R-Mutura/HDMI-T0-MIPI-2/hdmi_to_mipi-dsi_converter/assets/PCB Design.jpg

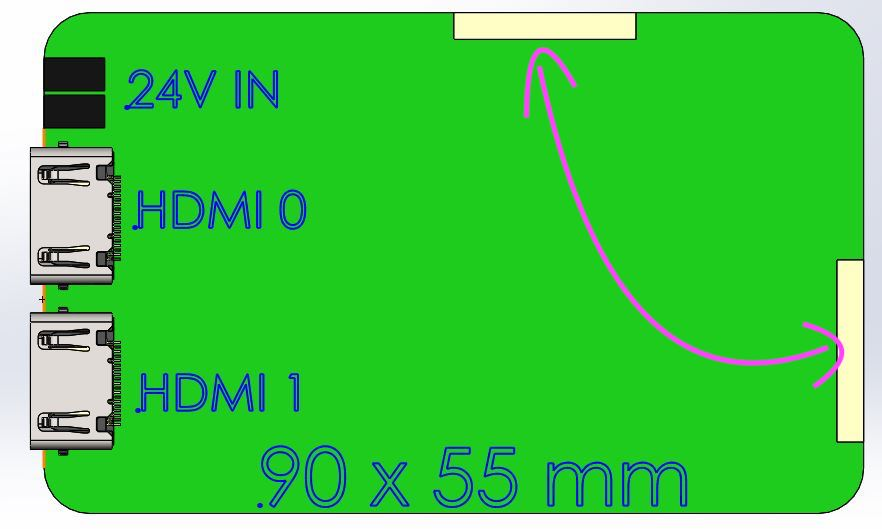
hdmi_to_mipi-dsi_converter/assets/PCB Design.jpg
