R-Mutura/HDMI-T0-MIPI-2/hdmi_to_mipi-dsi_converter/assets/image (2).png

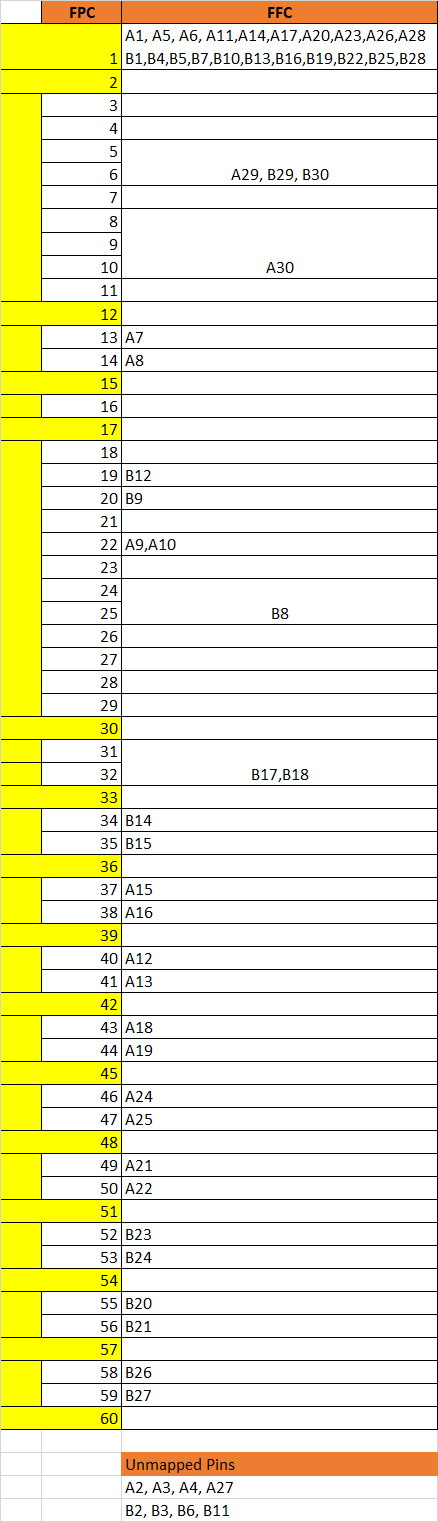
hdmi_to_mipi-dsi_converter/assets/image (2).png
