R-Mutura/HDMI-T0-MIPI-2/hdmi_to_mipi-dsi_converter/assets/TC358870_1.jpeg

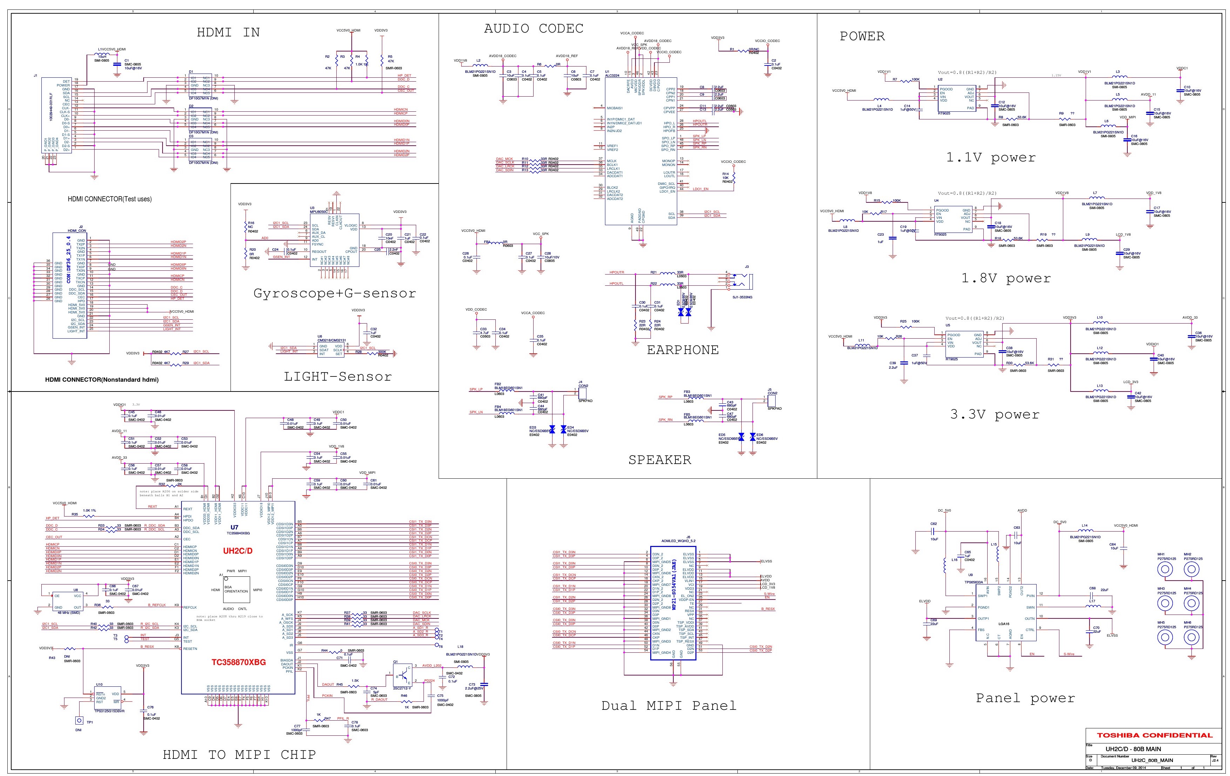
hdmi_to_mipi-dsi_converter/assets/TC358870_1.jpeg
