R-Mutura/HDMI-T0-MIPI-2/hdmi_to_mipi-dsi_converter/img/hdmi_to_mipi-dsi_converter_3.png

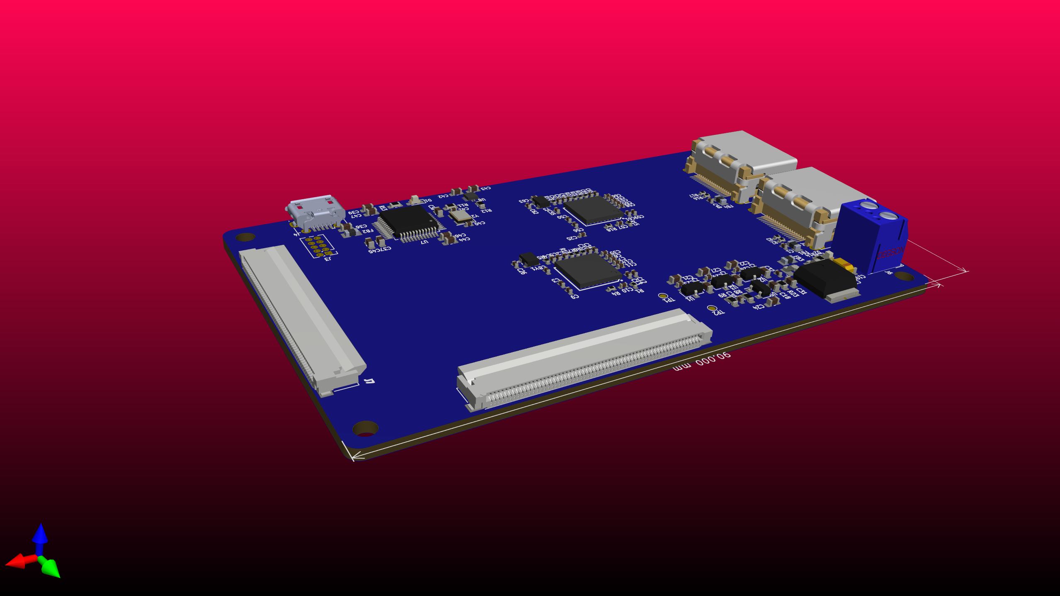
hdmi_to_mipi-dsi_converter/img/hdmi_to_mipi-dsi_converter_3.png
