R-Mutura/HDMI-T0-MIPI-2/hdmi_to_mipi-dsi_converter/bom/hdmi_to_mipi-dsi_converterV2.xlsx

Reference | Quantity | Value | Footprint | Mfr | Mfr# | Supplier
C13 C14 C11 C7 C3 C5 C9 C1 C32 C60 C61 C58 C54 C50 C52 C56 C48 | 17 | 10n | Capacitor_SMD:C_0402_1005Metric | YAGEO | CC0402KRX5R8BB103 | LCSC
C20 | 1 | 10u | Capacitor_Tantalum_SMD:CP_EIA-3216-18_Kemet-A | KEMET | T491A106K016AT | LCSC
C25 C12 C10 C6 C2 C4 C8 C35 C34 C33 C37 C38 C39 C42 C43 C28 C30 C29 C23 C59 C57 C49 C51 C55 C66 C65 C64 C53 C62 | 29 | 0.1u | Capacitor_SMD:C_0402_1005Metric | YAGEO | CC0402KRX7R7BB104 | LCSC
C26 C63 | 2 | 0.01u | Capacitor_SMD:C_0402_1005Metric | YAGEO | CC0402KRX5R8BB103 | LCSC
C19 C31 | 2 | 0.1u | Capacitor_SMD:C_0603_1608Metric | YAGEO | CC0603ZRY5V9BB104 | LCSC
C40 C41 | 2 | 18p | Capacitor_SMD:C_0402_1005Metric | YAGEO | CC0402JRNPO9BN180 | LCSC
C36 C15 C16 C17 C18 C24 C27 C21 C22 | 9 | 10u | Capacitor_SMD:C_0603_1608Metric | YAGEO | CC0603KRX5R6BB106 | LCSC
C44 C45 | 2 | 10u | Capacitor_SMD:C_0402_1005Metric | YAGEO | CC0402MRX5R5BB106 | LCSC
C46 C47 | 2 | 4.7u | Capacitor_SMD:C_0603_1608Metric | YAGEO | CC0603KRX5R6BB475 | LCSC
D1 D2 | 2 | LED_Small | LED_SMD:LED_0603_1608Metric_Castellated | Lite-On | LTST-C191KGKT | LCSC
FB1 FB4 | 2 | Ferrite_Bead_Small | Barrel - Audio Connectors:BEADC2012X105N | Murata Electronics | BLM21PG220SN1D | LCSC
FB2 FB3 | 2 | BLM21PG220SN1 | Barrel - Audio Connectors:BEADC2012X105N | Murata Electronics | BLM21PG220SN1D | LCSC
J2 J1 | 2 | HDMI-019S | HDMI:HDMI-019S | SOFNG | HDMI-019S | LCSC
J3 | 1 | Conn_02x05_Odd_Even | Connector_PinHeader_1.27mm:PinHeader_2x05_P1.27mm_Vertical | Amphenol ICC (FCI) | 20021111-00010T1LF | DIGIKEY
J4 | 1 | USB_B_Micro | Connector_USB:USB_Micro-B_Molex-105017-0001 | MOLEX | 1050170001 | LCSC
J5 J7 | 2 | XF2M60151AH | 60_PIN_FPC:XF2M60151AH | Omron Electronics | XF2M-6015-1AH | LCSC
J6 | 1 | Conn_01x02 | TerminalBlock_4Ucon:TerminalBlock_4Ucon_1x02_P3.50mm_Horizontal | Cixi Kefa Elec | KF350-3.5-2P | LCSC
R1 R10 R22 R15 | 4 | 2k | Resistor_SMD:R_0402_1005Metric | YAGEO | RC0402JR-072KL | LCSC
R12 | 1 | 47k | Resistor_SMD:R_0603_1608Metric | YAGEO | RC0603FR-0747KL | LCSC
R13 R14 | 2 | 1k | Resistor_SMD:R_0603_1608Metric | YAGEO | AC0603FR-071KL | LCSC
R2 R3 R4 R16 R18 R17 | 6 | 47k | Resistor_SMD:R_0402_1005Metric | YAGEO | RC0402DR-0747KL | LCSC
R23 | 1 | 0R | Resistor_SMD:R_0603_1608Metric | YAGEO | RC0603JR-070RL | LCSC
R5 R19 | 2 | 33R | Resistor_SMD:R_0402_1005Metric | YAGEO | RC0402FR-0733RL | LCSC
R7 R6 R11 R21 R20 | 5 | 10k | Resistor_SMD:R_0402_1005Metric | YAGEO | SR0402FR-0710KL | LCSC
R8 | 1 | 4.02k | Resistor_SMD:R_0603_1608Metric | YAGEO | AC0603FR-074K02L | LCSC
R9 | 1 | 2k | Resistor_SMD:R_0603_1608Metric | YAGEO | RC0603FR-072KL | LCSC
U1 | 1 | MCP1700-1202E_SOT23 | Package_TO_SOT_SMD:SOT-23 | Microchip Tech | MCP1700-1202E_SOT23 | LCSC
U2 | 1 | MCP1700-1802E_SOT23 | Package_TO_SOT_SMD:SOT-23 | Microchip Tech | MCP1700-1802E_SOT23 | LCSC
U3 U5 | 2 | MCP1700-3302E_SOT23 | Package_TO_SOT_SMD:SOT-23 | Microchip Tech | MCP1700T-3302E/TT | LCSC
U4 U9 | 2 | TC358870XBG_NOK_ | Barrel - Audio Connectors:BGA80C65P10X10_700X700X100 | Toshiba | TC358870XBG(NOK) | MOUSER
U6 | 1 | MC78M05_TO252 | Package_TO_SOT_SMD:TO-252-2 | ON Semiconductor | MC78M05ACDTG | LCSC
U7 | 1 | STM32F103C8Tx | Package_QFP:LQFP-48_7x7mm_P0.5mm | STMicroelectronics | STM32F103C8T6 | LCSC
U8 | 1 | FXMA2104UMX | Barrel - Audio Connectors:QFN40P180X180X55-12N | ON Semiconductor | FXMA2104UMX | LCSC
Y1 Y3 | 2 | CRYSTAL_48MHZ | Barrel - Audio Connectors:DSC6101JI2A-048.0000 | Microchip Technology | DSC6101JI2A-048.0000 | DIGIKEY
Y2 | 1 | 8MHz | Crystal:Crystal_SMD_3225-4Pin_3.2x2.5mm | XTY | 7325-0800A2010-00 | LCSC
