R-Mutura/HDMI-T0-MIPI-2/hdmi_to_mipi-dsi_converter/sch_pdf/hdmi_to_mipi-dsi_converter.pdf

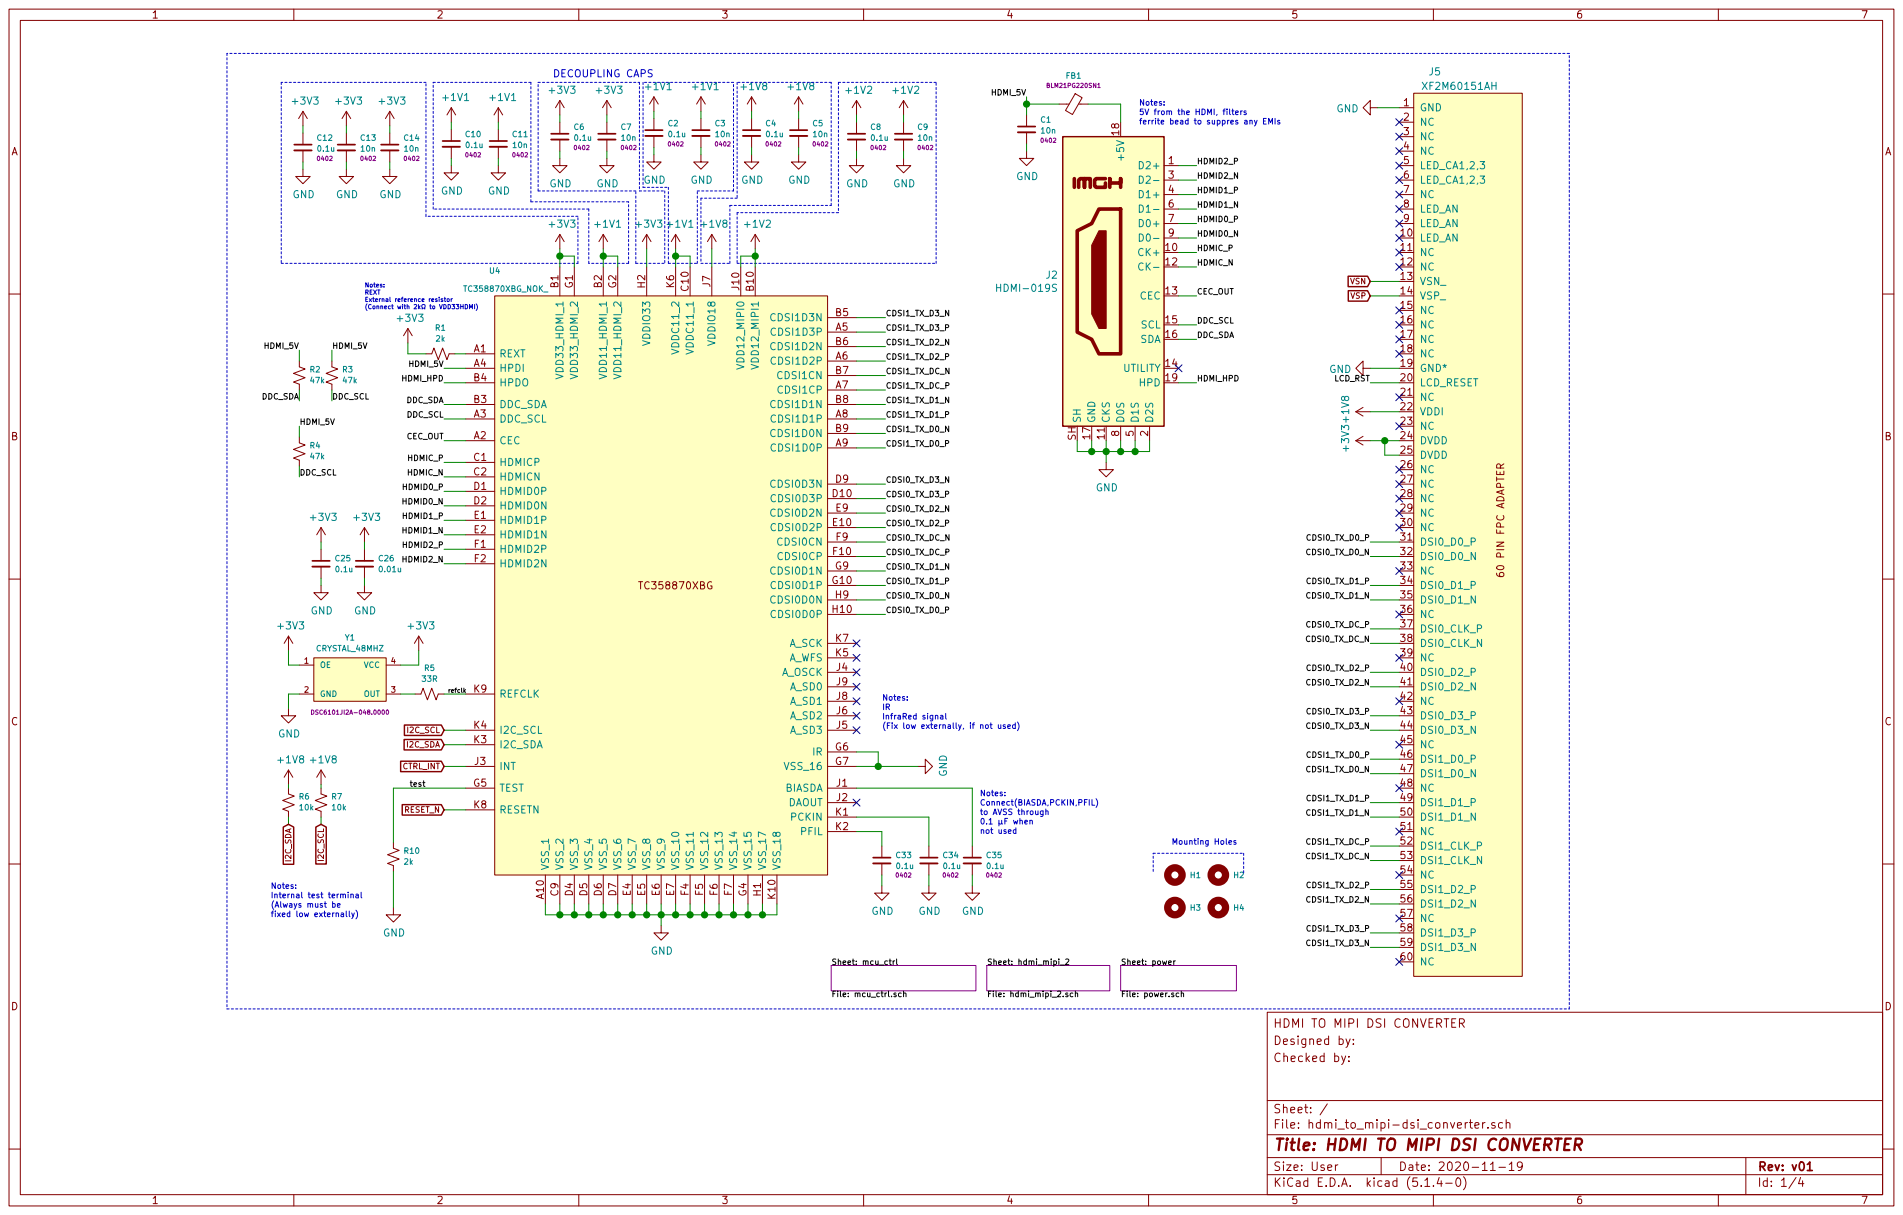
[picture p15: page 1]

Notes: 5V from the HDMI, filters

ferrite bead to suppres any EMIs

Notes: REXT External reference resistor

InfraRed signal (Fix low externally, if not used) Notes: Connect(BIASDA,PCKIN,PFIL)

Internal test terminal (Always must be

Designed by: HDMI TO MIPI DSI CONVERTER

File: hdmi_to_mipi-dsi_converter.sch Sheet: / Checked by:

Id: 1/4 Title: HDMI TO MIPI DSI CONVERTER

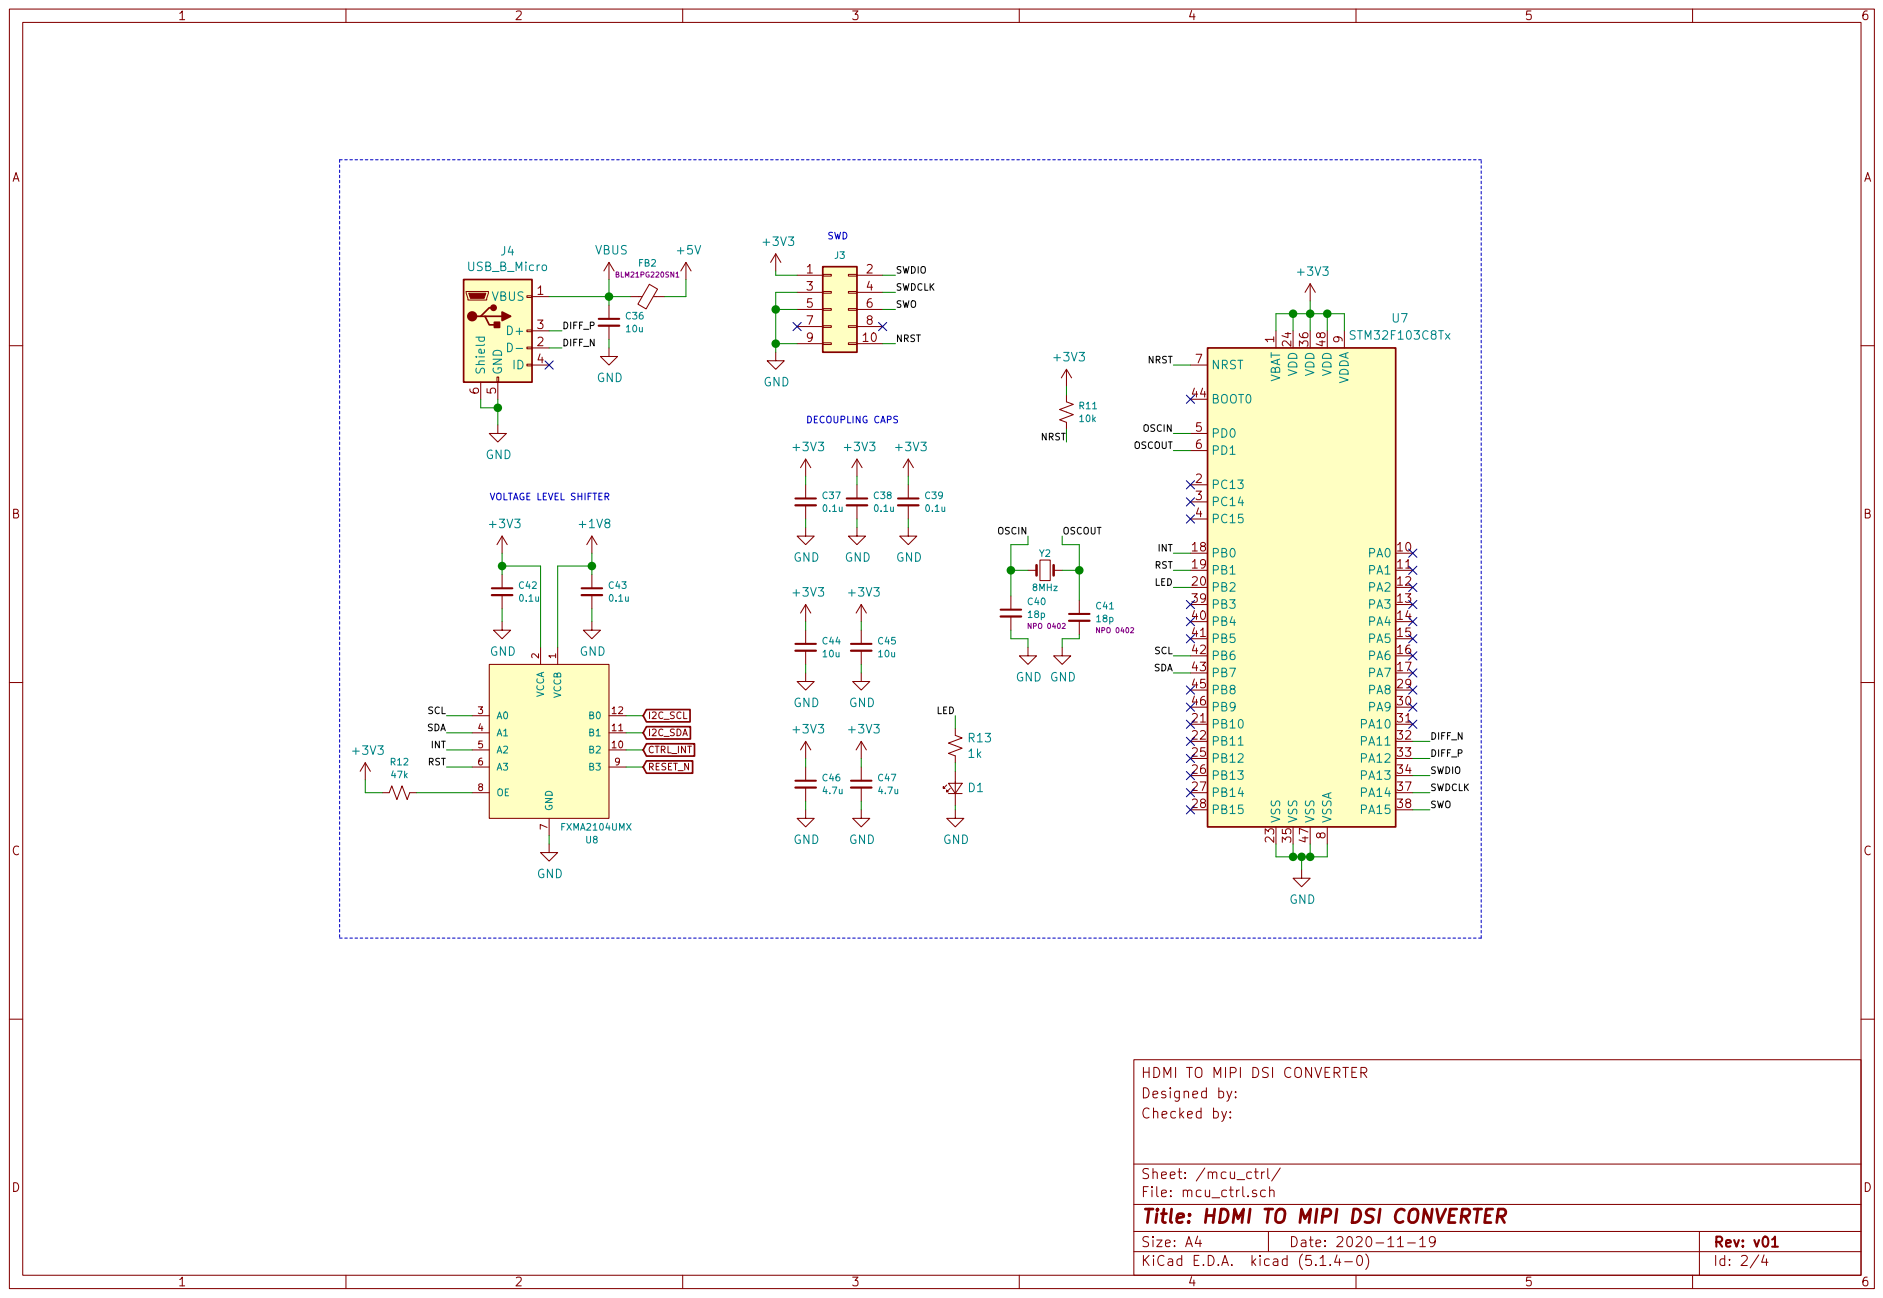
[picture p16: page 2]

1 VDD 24 VDD 36 VDD 48 VDDA

9 VSS 23 VSS 35 VSS 47 VSSA

Designed by: HDMI TO MIPI DSI CONVERTER

Sheet: /mcu_ctrl/
File: mcu_ctrl.sch
Id: 2/4 Title: HDMI TO MIPI DSI CONVERTER

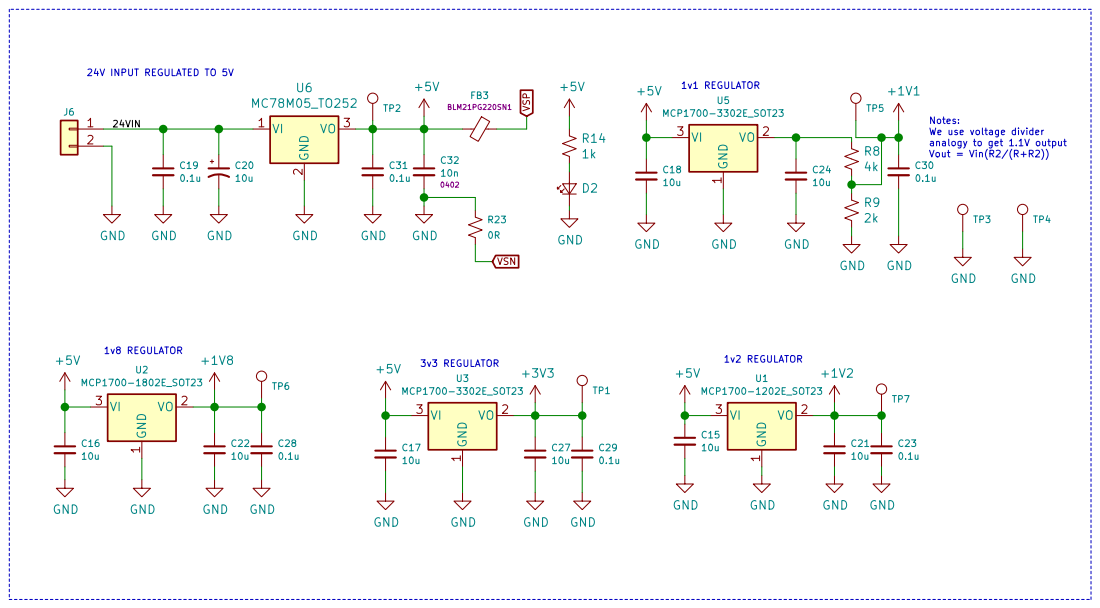
[picture p17: page 3]

1v1 REGULATOR
+1V1 GND
Designed by: HDMI TO MIPI DSI CONVERTER GND

1 VO 2 VI 3 U5 MCP1700-3302E_SOT23 GND GND GND GND

Sheet: /power/
File: power.sch
Id: 3/4 Title: HDMI TO MIPI DSI CONVERTER

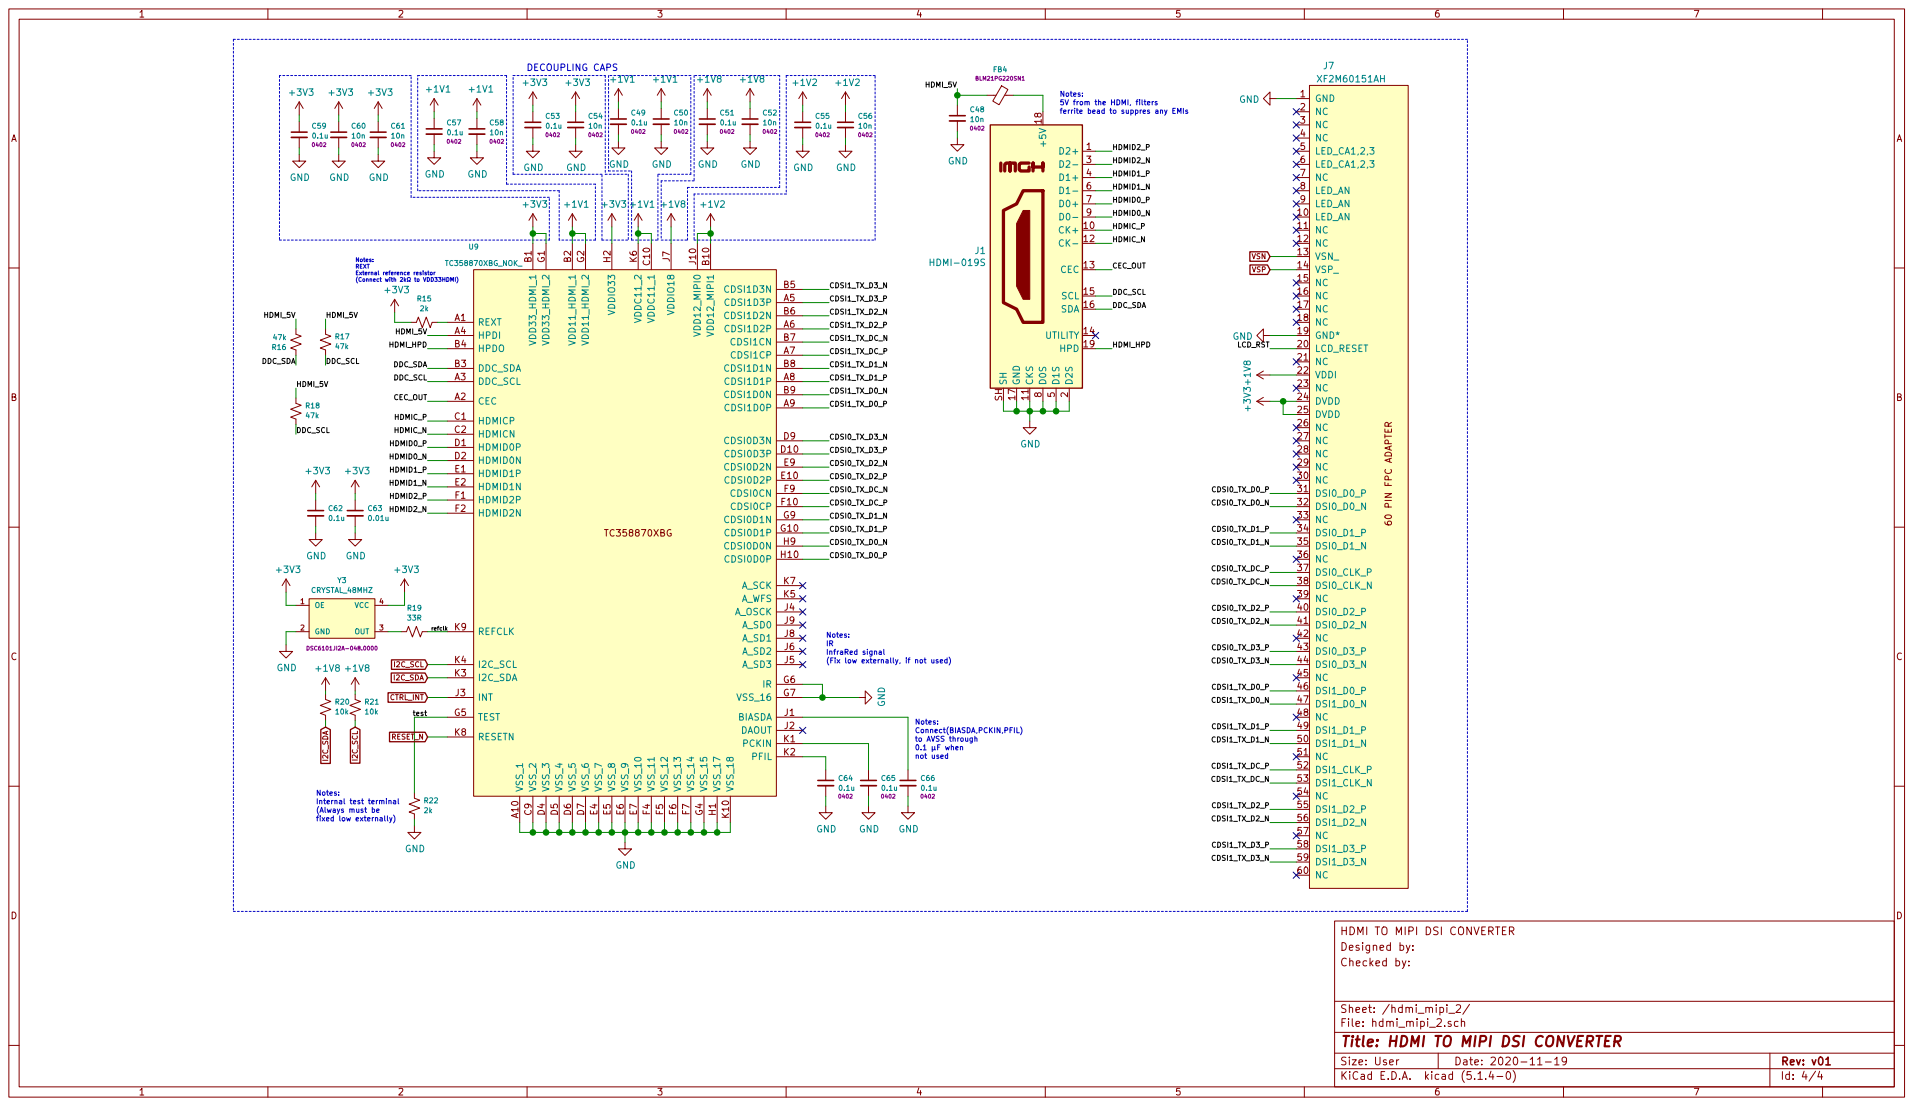
[picture p18: page 4]

ferrite bead to suppres any EMIs Notes: REXT External reference resistor

InfraRed signal (Fix low externally, if not used)

CDSI1_TX_D2_P Notes:
Internal test terminal (Always must be

Designed by: HDMI TO MIPI DSI CONVERTER

Sheet: /hdmi_mipi_2/
File: hdmi_mipi_2.sch
Id: 4/4 Title: HDMI TO MIPI DSI CONVERTER
