R-Mutura/HDMI-T0-MIPI-2/hdmi_to_mipi-dsi_converter/src_files/hdmi_to_mipi-dsi_converter.kicad_pcb

## KiCad design hdmi_to_mipi-dsi_converter/src_files/hdmi_to_mipi-dsi_converter.kicad_pcb (2021-11-17)

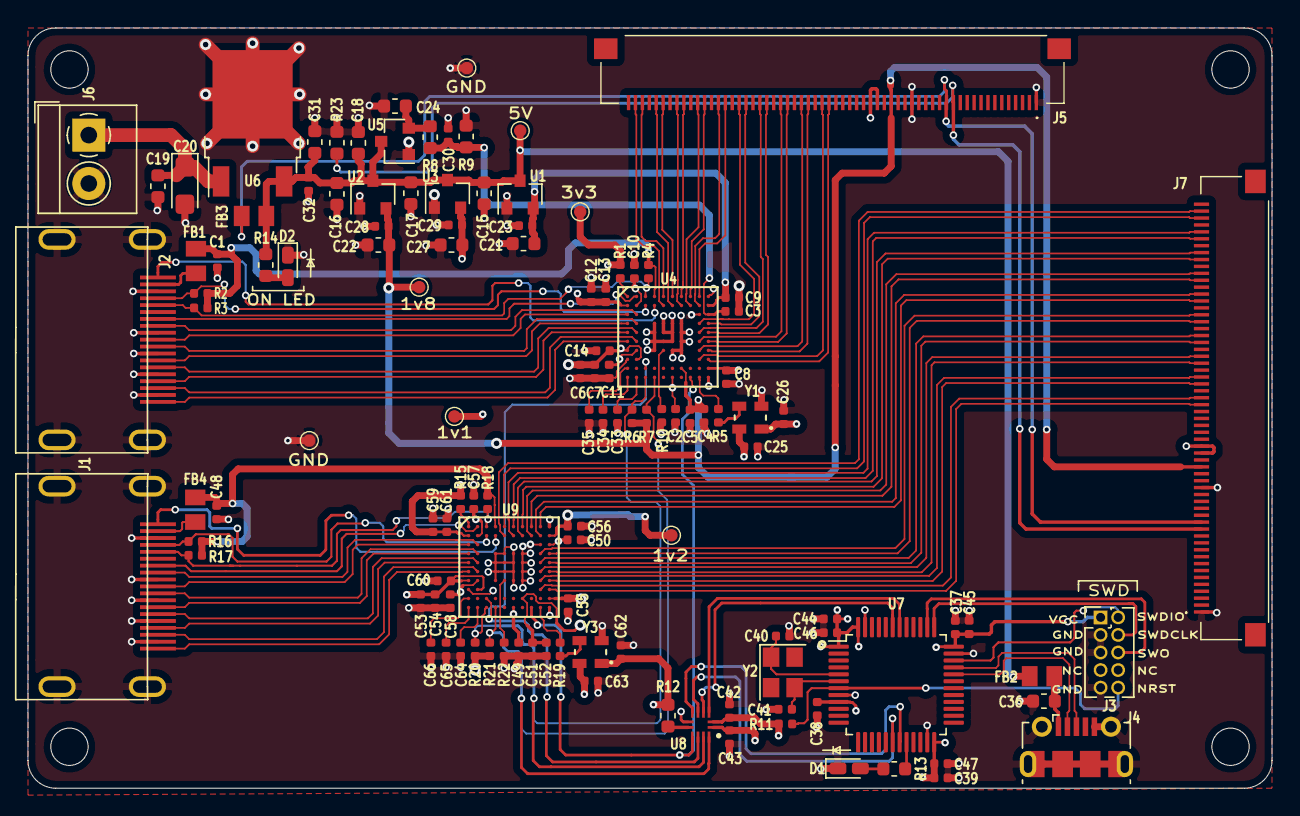
[picture p19: board hdmi_to_mipi-dsi_converter.kicad_pcb from above]

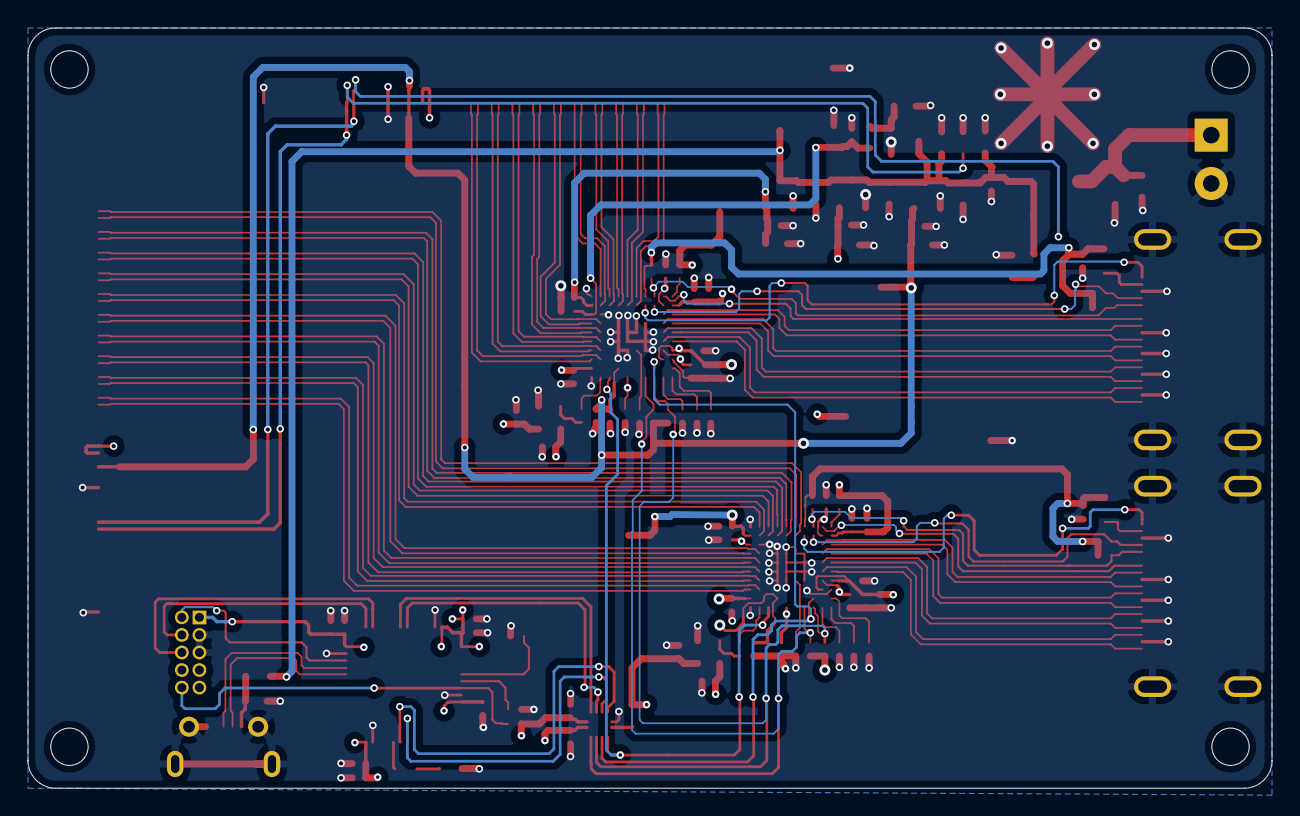
[picture p20: board hdmi_to_mipi-dsi_converter.kicad_pcb from below]

Board: 4 copper layers, 90.0 x 55.0 mm, 125 parts (4 on the bottom side), 113 nets.

Parts:
C1, C3, C5, C7, C9, C11, C13, C14, C32, C48, C50, C52, C54, C56, C58, C60, C61: 10n; C_0402_1005Metric
C2, C4, C6, C8, C10, C12, C23, C25, C28, C29, C30, C33, C34, C35, C37, C38, C39, C42, C43, C49, C51, C53, C55, C57, C59, C62, C64, C65, C66: 0.1u; C_0402_1005Metric
C15, C16, C17, C18, C21, C22, C24, C27, C36: 10u; C_0603_1608Metric
C19, C31: 0.1u; C_0603_1608Metric
C20: 10u; CP_EIA-3216-18_Kemet-A
C26, C63: 0.01u; C_0402_1005Metric
C40, C41: 18p; C_0402_1005Metric
C44, C45: 10u; C_0402_1005Metric
C46, C47: 4.7u; C_0402_1005Metric
D1, D2: LED_Small; LED_0603_1608Metric_Castellated
FB1, FB4: Ferrite_Bead_Small; BEADC2012X105N
FB2, FB3: BLM21PG220SN1; BEADC2012X105N
H1, H2, H3, H4: MountingHole; MountingHole_2.7mm_M2.5
J1, J2: HDMI-019S
J3: Conn_02x05_Odd_Even; PinHeader_2x05_P1.27mm_Vertical
J4: USB_B_Micro; USB_Micro-B_Molex-105017-0001
J5, J7: XF2M60151AH
J6: Conn_01x02; TerminalBlock_4Ucon_1x02_P3.50mm_Horizontal
R1, R10, R15, R22: 2k; R_0402_1005Metric
R2, R3, R4, R16, R17, R18: 47k; R_0402_1005Metric
R5, R19: 33R; R_0402_1005Metric
R6, R7, R11, R20, R21: 10k; R_0402_1005Metric
R8: 4k; R_0603_1608Metric
R9: 2k; R_0603_1608Metric
R12: 47k; R_0603_1608Metric
R13, R14: 1k; R_0603_1608Metric
R23: 0R; R_0603_1608Metric
TP1, TP2, TP3, TP4, TP5, TP6, TP7: TestPoint; TestPoint_Pad_D0.9mm
U1: MCP1700-1202E_SOT23; SOT-23
U2: MCP1700-1802E_SOT23; SOT-23
U3, U5: MCP1700-3302E_SOT23; SOT-23
U4, U9: TC358870XBG_NOK_; VFBGA-80_7x7mm_Pitch0.65mm
U6: MC78M05_TO252; TO-252-2
U7: STM32F103C8Tx; LQFP-48_7x7mm_P0.5mm
U8: FXMA2104UMX; QFN40P180X180X55-12N
Y1, Y3: CRYSTAL_48MHZ; DSC6101JI2A-048.0000
Y2: 8MHz; Crystal_SMD_3225-4Pin_3.2x2.5mm

Connections:
+1V1: C2.1, C3.1, C10.1, C11.1, C30.1, C49.1, C50.1, C57.1, C58.1, R8.2, R9.1, TP5.1, U4.B2, U4.C10, U4.G2, U4.K6, U9.B2, U9.C10, U9.G2, U9.K6
+1V2: C8.1, C9.1, C21.1, C23.1, C55.1, C56.1, TP7.1, U1.2, U4.B10, U4.J10, U9.B10, U9.J10
+1V8: C4.1, C5.1, C22.1, C28.1, C43.1, C51.1, C52.1, J5.22, J7.22, R6.2, R7.2, R20.2, R21.2, TP6.1, U2.2, U4.J7, U8.1, U9.J7
+3V3: C6.1, C7.1, C12.1, C13.1, C14.1, C25.1, C26.1, C27.1, C29.1, C37.1, C38.1, C39.1, C42.1, C44.1, C45.1, C46.1, C47.1, C53.1, C54.1, C59.1, C60.1, C61.1, C62.1, C63.1, J3.1, J5.24, J5.25, J7.24, J7.25, R1.2, R11.1, R12.2, R15.2, TP1.1, U3.2, U4.B1, U4.G1, U4.H2, U7.1, U7.9, U7.24, U7.36, U7.48, U8.2, U9.B1, U9.G1, U9.H2, Y1.1, Y1.4, Y3.1, Y3.4
+5V: C15.1, C16.1, C17.1, C18.1, C31.1, C32.1, FB2.1, FB3.2, R14.1, TP2.1, U1.3, U2.3, U3.3, U5.3, U6.3
/CDSI0_TX_D0_N: J5.32, U4.H9
/CDSI0_TX_D0_P: J5.31, U4.H10
/CDSI0_TX_D1_N: J5.35, U4.G9
/CDSI0_TX_D1_P: J5.34, U4.G10
/CDSI0_TX_D2_N: J5.41, U4.E9
/CDSI0_TX_D2_P: J5.40, U4.E10
/CDSI0_TX_D3_N: J5.44, U4.D9
/CDSI0_TX_D3_P: J5.43, U4.D10
/CDSI0_TX_DC_N: J5.38, U4.F9
/CDSI0_TX_DC_P: J5.37, U4.F10
/CDSI1_TX_D0_N: J5.47, U4.B9
/CDSI1_TX_D0_P: J5.46, U4.A9
/CDSI1_TX_D1_N: J5.50, U4.B8
/CDSI1_TX_D1_P: J5.49, U4.A8
/CDSI1_TX_D2_N: J5.56, U4.B6
/CDSI1_TX_D2_P: J5.55, U4.A6
/CDSI1_TX_D3_N: J5.59, U4.B5
/CDSI1_TX_D3_P: J5.58, U4.A5
/CDSI1_TX_DC_N: J5.53, U4.B7
/CDSI1_TX_DC_P: J5.52, U4.A7
/CEC_OUT: J2.13, U4.A2
/DDC_SCL: J2.15, R3.1, R4.1, U4.A3
/DDC_SDA: J2.16, R2.1, U4.B3
/HDMIC_N: J2.12, U4.C2
/HDMIC_P: J2.10, U4.C1
/HDMID0_N: J2.9, U4.D2
/HDMID0_P: J2.7, U4.D1
/HDMID1_N: J2.6, U4.E2
/HDMID1_P: J2.4, U4.E1
/HDMID2_N: J2.3, U4.F2
/HDMID2_P: J2.1, U4.F1
/HDMI_5V: C1.1, FB1.2, R2.2, R3.2, R4.2, U4.A4
/HDMI_HPD: J2.19, U4.B4
/hdmi_mipi_2/CDSI0_TX_D0_N: J7.32, U9.H9
/hdmi_mipi_2/CDSI0_TX_D0_P: J7.31, U9.H10
/hdmi_mipi_2/CDSI0_TX_D1_N: J7.35, U9.G9
/hdmi_mipi_2/CDSI0_TX_D1_P: J7.34, U9.G10
/hdmi_mipi_2/CDSI0_TX_D2_N: J7.41, U9.E9
/hdmi_mipi_2/CDSI0_TX_D2_P: J7.40, U9.E10
/hdmi_mipi_2/CDSI0_TX_D3_N: J7.44, U9.D9
/hdmi_mipi_2/CDSI0_TX_D3_P: J7.43, U9.D10
/hdmi_mipi_2/CDSI0_TX_DC_N: J7.38, U9.F9
/hdmi_mipi_2/CDSI0_TX_DC_P: J7.37, U9.F10
/hdmi_mipi_2/CDSI1_TX_D0_N: J7.47, U9.B9
/hdmi_mipi_2/CDSI1_TX_D0_P: J7.46, U9.A9
/hdmi_mipi_2/CDSI1_TX_D1_N: J7.50, U9.B8
/hdmi_mipi_2/CDSI1_TX_D1_P: J7.49, U9.A8
/hdmi_mipi_2/CDSI1_TX_D2_N: J7.56, U9.B6
/hdmi_mipi_2/CDSI1_TX_D2_P: J7.55, U9.A6
/hdmi_mipi_2/CDSI1_TX_D3_N: J7.59, U9.B5
/hdmi_mipi_2/CDSI1_TX_D3_P: J7.58, U9.A5
/hdmi_mipi_2/CDSI1_TX_DC_N: J7.53, U9.B7
/hdmi_mipi_2/CDSI1_TX_DC_P: J7.52, U9.A7
/hdmi_mipi_2/CEC_OUT: J1.13, U9.A2
/hdmi_mipi_2/DDC_SCL: J1.15, R17.1, R18.1, U9.A3
/hdmi_mipi_2/DDC_SDA: J1.16, R16.2, U9.B3
/hdmi_mipi_2/HDMIC_N: J1.12, U9.C2
/hdmi_mipi_2/HDMIC_P: J1.10, U9.C1
/hdmi_mipi_2/HDMID0_N: J1.9, U9.D2
/hdmi_mipi_2/HDMID0_P: J1.7, U9.D1
/hdmi_mipi_2/HDMID1_N: J1.6, U9.E2
/hdmi_mipi_2/HDMID1_P: J1.4, U9.E1
/hdmi_mipi_2/HDMID2_N: J1.3, U9.F2
/hdmi_mipi_2/HDMID2_P: J1.1, U9.F1
/hdmi_mipi_2/HDMI_5V: C48.1, FB4.2, R16.1, R17.2, R18.2, U9.A4
/hdmi_mipi_2/HDMI_HPD: J1.19, U9.B4
/hdmi_mipi_2/refclk: R19.1, U9.K9
/hdmi_mipi_2/test: R22.2, U9.G5
/mcu_ctrl/DIFF_N: J4.2, U7.32
/mcu_ctrl/DIFF_P: J4.3, U7.33
/mcu_ctrl/INT: U7.18, U8.5
/mcu_ctrl/LED: R13.1, U7.20
/mcu_ctrl/NRST: J3.10, R11.2, U7.7
/mcu_ctrl/OSCIN: C40.1, U7.5, Y2.1
/mcu_ctrl/OSCOUT: C41.1, U7.6, Y2.3
/mcu_ctrl/RST: U7.19, U8.6
/mcu_ctrl/SCL: U7.42, U8.3
/mcu_ctrl/SDA: U7.43, U8.4
/mcu_ctrl/SWDCLK: J3.4, U7.37
/mcu_ctrl/SWDIO: J3.2, U7.34
/mcu_ctrl/SWO: J3.6, U7.38
/power/24VIN: C19.1, C20.1, J6.1, U6.1
/refclk: R5.1, U4.K9
/test: R10.2, U4.G5
CTRL_INT: U4.J3, U8.10, U9.J3
GND: C1.2, C2.2, C3.2, C4.2, C5.2, C6.2, C7.2, C8.2, C9.2, C10.2, C11.2, C12.2, C13.2, C14.2, C15.2, C16.2, C17.2, C18.2, C19.2, C20.2, C21.2, C22.2, C23.2, C24.2, C25.2, C26.2, C27.2, C28.2, C29.2, C30.2, C31.2, C32.2, C33.2, C34.2, C35.2, C36.2, C37.2, C38.2, C39.2, C40.2, C41.2, C42.2, C43.2, C44.2, C45.2, C46.2, C47.2, C48.2, C49.2, C50.2, C51.2, C52.2, C53.2, C54.2, C55.2, C56.2, C57.2, C58.2, C59.2, C60.2, C61.2, C62.2, C63.2, C64.2, C65.2, C66.2, D1.1, D2.1, J1.2, J1.5, J1.8, J1.11, J1.17, J1.SH, J2.2, J2.5, J2.8, J2.11, J2.17, J2.SH, J3.3, J3.5, J3.9, J4.5, J4.6, J5.1, J5.19, J6.2, J7.1, J7.19, R9.2, R10.1, R22.1, R23.1, TP3.1, TP4.1, U1.1, U2.1, U3.1, U4.A10, U4.C9, U4.D4, U4.D5, U4.D6, U4.D7, U4.E4, U4.E5, U4.E6, U4.E7, U4.F4, U4.F5, U4.F6, U4.F7, U4.G4, U4.G6, U4.G7, U4.H1, U4.K10, U5.1, U6.2, U7.8, U7.23, U7.35, U7.47, U8.7, U9.A10, U9.C9, U9.D4, U9.D5, U9.D6, U9.D7, U9.E4, U9.E5, U9.E6, U9.E7, U9.F4, U9.F5, U9.F6, U9.F7, U9.G4, U9.G6, U9.G7, U9.H1, U9.K10, Y1.2, Y3.2
I2C_SCL: R7.1, R21.1, U4.K4, U8.12, U9.K4
I2C_SDA: R6.1, R20.1, U4.K3, U8.11, U9.K3
unnamed: C24.1, R8.1, U5.2
unnamed: C33.1, U4.K2
unnamed: C34.1, U4.K1
unnamed: C35.1, U4.J1
unnamed: C64.1, U9.K2
unnamed: C65.1, U9.K1
unnamed: C66.1, U9.J1
unnamed: D1.2, R13.2
unnamed: D2.2, R14.2
unnamed: FB1.1, J2.18
unnamed: FB4.1, J1.18
unnamed: R1.1, U4.A1
unnamed: R5.2, Y1.3
unnamed: R12.1, U8.8
unnamed: R15.1, U9.A1
unnamed: R19.2, Y3.3
RESET_N: U4.K8, U8.9, U9.K8
VBUS: C36.1, FB2.2, J4.1
VSN: J5.13, J7.13, R23.2
VSP: FB3.1, J5.14, J7.14
